khvalov/BattleDrome/(commit log)

2026-04-24 Create wheely.ino
    Initial code for Bluetooth controller and wheels drive
2026-04-24 Add central server dashboard and per-tank MQTT topics
    - Add server/index.js: subscribes to battledrome/tanks/+/events via MQTT,
    tracks online/offline state with 15s timeout, serves dashboard over HTTP
    and pushes real-time updates to browsers via WebSocket
    - Add server/public/index.html: dark-themed live dashboard showing each tank
    as a card with online/offline status, last-seen timestamp, and last event
    - Add server/package.json with mqtt and ws dependencies
    - Update eqipement/tanks/raspberry/server.js to publish on a per-tank topic
    (battledrome/tanks/{hostname}/events) so the central server can identify
    individual tanks via MQTT wildcard subscription
    - Add CLAUDE.md with project a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
2026-04-24 Add telemetry, heartbeat, command routing, and dashboard stats
    Arduino (wheely.ino):
    - Add game-state variables: health=100, ammo=100, ammoLevel=3,
    fireSpeed=5, immunable=false
    - Track per-motor abs speed; send avg as telemetry via Serial2 every 500ms
    - Parse incoming JSON commands on Serial2 to update variables at runtime
    - Use Serial2 (MegaPi predefined RPi UART) instead of Serial1
    - Requires ArduinoJson library
    Raspberry Pi (server.js):
    - Subscribe to battledrome/tanks/{hostname}/commands on connect
    - Forward received commands directly to Arduino via UART serial
    - Add heartbeat every 5s to prevent central server offline timeout
    Central server (server/index.js):
    - Merge telemetry paylo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
    [server.js, wheely.ino]
2026-04-25 Add IR firing, tank identity, fire events, and telemetry log
    wheely.ino:
    - Add TANK_ID ("WHLYA1") and TANK_TYPE ("wheely") settings constants
    - Add IR_TX_PIN placeholder (pin 3) with fireIR() stub — replace body
    with your IR library call (e.g. irsend.sendNEC)
    - Square button (PS2_SQUARE rising edge) triggers a shot when ammo > 0
    and fireSpeed ms have elapsed since the last shot
    - Each shot: decrements ammo by 1, calls fireIR(), sends fire event
    - fire event payload: tankId, tankType, senderId, ammoLevel, remaining ammo
    - telemetry payload now includes tankId and tankType
    raspberry/server.js:
    - Add getLocalIP() using os.networkInterfaces()
    - Enrich telemetry and fire events with ip and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
    [server.js, wheely.ino]
2026-04-29 Add RFID reader support and RFID-triggered action dispatch
    - Add MFRC522 RFID reader on RST_PIN=30, SS_PIN=22 via hardware SPI
    - readRfidUid() reads card UID as uppercase hex, halts card after read,
    applies 3 s per-UID debounce to prevent repeated triggers
    - sendRfidEvent() sends rfid JSON event over Serial2 on each scan
    - SPI.begin() + rfid.PCD_Init() added to setup()
    - Enrich rfid events with ip and hostname alongside telemetry and fire
    server/index.js:
    - Add RFID_ACTIONS map: UID → { param, value } command (commented examples
    for medkit, ammo crate, shield, nitro, power-up)
    - On rfid event: log UID + tank to console, look up action, publish
    comma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
    [server.js, wheely.ino]
2026-04-29 Fix handleCommand JSON buffer too small — commands silently dropped (#6)
    * Add RFID management UI with action/recipient/value rules and win overlay
    - Dashboard: RFID Actions section with colored table, add/edit/delete form
    - Server: REST API (GET/POST/DELETE /api/rfid), delta-based value dispatch
    - Win action broadcasts to browsers instead of sending tank command
    - Recipient routing: tank / others / teammate / all
    - Win overlay: full-screen trophy display with contextual message
    * Fix StaticJsonDocument too small in handleCommand — commands were silently dropped
    128 bytes was not enough for the incoming command JSON (~79 bytes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
    [wheely.ino]
2026-04-29 Add maxSpeed/minSpeed: default 160/20, RFID-overridable, shown in telemetry (#7)
    Firmware (wheely.ino):
    - Replace const MAX_SPEED=255 with int maxSpeed=160 (runtime-mutable)
    - Add int minSpeed=20 (floor applied to non-zero motor outputs)
    - applyMinSpd() helper enforces the floor after maxSpeed scaling
    - mecanumDrive() now clamps output to maxSpeed then raises to minSpeed
    - sendTelemetry() includes maxSpeed and minSpeed (doc bumped to 384)
    - handleCommand() handles maxSpeed [1,255] and minSpeed [0,255] params
    Server (index.js):
    - ACTION_PARAM: maxspeed→maxSpeed, minspeed→minSpeed
    - PARAM_RANGE: maxSpeed [1,255], minSpeed [0,255]
    - VALID_ACTIONS includes maxspeed and minspeed
    Dashboard (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
    [wheely.ino]
2026-04-29 Add WS2812 2x2 health LED on pin 60 (#8)
    - Include Adafruit_NeoPixel (install via Library Manager)
    - 4-pixel strip on pin 60 (= A6 on ATmega2560), brightness 80/255
    - updateHealthLed(): green (health>50) / yellow (health 5-50) / red (health<5)
    - Called at boot (setup) and immediately on every incoming health command
2026-04-29 Switch health LED from Adafruit_NeoPixel to MeRGBLed on pin A14 (#9)
    MeRGBLed is bundled with MeMegaPi — no extra library install needed.
    Pin changed from 60 to A14 (= pin 68 on ATmega2560).
    Setup: healthLed.setpin(A14); healthLed.setNumber(4);
    updateHealthLed() uses setColor(r,g,b) + show() — same colour zones:
    health > 50 → green | 5-50 → yellow | < 5 → red
    Also restores full file header lost during prior rebase stash.
2026-04-30 Hardware updates, dual LEDs, NEC IR, tank rename UI (#10)
    * Update SS_PIN, RFID cooldown, dual LEDs, NEC IR, system event handling
    - SS_PIN: 22 → 7
    - RFID_COOLDOWN_MS: 3000 → 5000
    - Add second MeRGBLed on A13 (led2); led1 stays on A14
    - Both LEDs yellow at boot (waiting for RPi), green when RPi sends
    system/connected via UART; health colours apply after that
    - handleCommand replaced by handleSerialLine: routes 'command' events
    as before, 'system/connected' sets rpiConnected and triggers LED switch
    - IR blaster moved from pin 3 to A12 (pin 66); fireIR() now sends a
    real 38 kHz NEC frame: addr = XOR-fold of TANK_ID, cmd = ammoLevel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
    [wheely.ino]
2026-04-30 Fix RFID silence and LEDs stuck yellow (#11)
    real 38 kHz NEC frame: addr = XOR-fold of TANK_ID, cmd = ammoLevel
    * Ad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
    [wheely.ino]
2026-04-30 Wheely: A6 SS_PIN, RFID debug logging, rename input focus fix (#12)
    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
    [wheely.ino]
2026-04-30 feat: ping-pong RPi connectivity check — fix LEDs stuck yellow on boot (#13)
    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
    [server.js, wheely.ino]
2026-04-30 debug: RPi serial write errors + MQTT subscription confirmation (#14)
    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
    [server.js]
2026-04-30 fix: RPi→Arduino serial pipeline — buffer overflow, minification, 64-byte guard (#15)
    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
    [server.js, wheely.ino]
2026-05-05 feat: implement 5 game modes in the web console (#16)
    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
2026-05-06 refactor(dashboard): redesign game panel UX for clarity
    Complete rework of the Game Control UI:
    Mode selector
    - Replaced dropdown with tabs — Free Play / CTF Teams / CTF Solo /
    Treasure Hunt / Race are always visible and one click to switch
    CTF Teams flow (the main pain point)
    - Step 1 label: "Create teams" with ＋ Add Team button that expands
    an inline form (name + color picker + home RFID UID)
    - Each team card shows a colored left bar, name, home UID, and a
    dedicated "Tanks in this team" section with named chips
    - Step 2 label: "Assign tanks" — each team card has a dropdown of
    unassigned tanks + "+ Add Tank" button; chips show current members
    with ✕ to remove; already-as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
2026-05-06 feat(trinity): rewrite firmware based on wheely architecture
    Hardware for this tank:
    - Motors: MeMegaPiDCMotor on PORT_1 (left) and PORT_4 (right) — differential
    drive, replaces the encoder-based Encoder_3/Encoder_4 of the old code
    - RFID: SS_PIN=6, RST_PIN=30 (SPI, same library as wheely)
    - IR receivers: A14 (pin 68) and A13 (pin 67), time-multiplexed with IRremote
    - IR transmitter: A12 (pin 66), wheely's software NEC implementation
    - No Raspberry Pi yet — Serial2 not started; status printed to USB serial only
    Key changes from old trinity.ino
    - Follows wheely.ino code structure (same game-state vars, same NEC TX code,
    same RFID debounce, same PWM timer setup, same fire-on-Square lo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
    [trinity.ino]
2026-05-06 feat(trinity): add Serial2/RPi support with full telemetry pipeline
    Enable UART communication with Raspberry Pi on Trinity tank:
    - Add ArduinoJson dependency for JSON encode/decode
    - Serial2.begin(115200) in setup() for Pi UART link
    - Ping-pong heartbeat every 5s; rpiConnected flag set on first pong
    - sendTelemetry() — health/ammo/speed/flags to Serial2 every 500ms
    - sendFireEvent() — immediate shot notification to Serial2
    - sendRfidEvent() — RFID scan forwarded to Pi (replaces TODO comment)
    - handleSerialLine() — parse incoming commands (health, ammo, ammoLevel,
    fireSpeed, immunable, maxSpeed, minSpeed); health and maxSpeed changes
    also call updateSpeedFromHealth() (Trinity-spec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
    [trinity.ino]
2026-05-06 fix(trinity): add missing SoftwareSerial.h include
    Required by MeMegaPi/MePS2 library chain — matches wheely.ino include order.
    [trinity.ino]
2026-05-06 fix(trinity): correct SS_PIN to A6 for RFID reader
    Pin 6 (digital) was wrong — RFID CS is wired to A6 (pin 60 on ATmega2560),
    same convention as wheely.
    [trinity.ino]
2026-05-06 feat(ir): add dual IR receive to wheely; update RX pins to A11/A10 on both tanks
    Wheely:
    - Add IRremote library include
    - IR RX on A11 (pin 65) + A10 (pin 64), time-multiplexed every 50 ms
    - handleIRReceive(): decode NEC, validate checksums, apply damage, blink red LED,
    update health LED, log attacker addr (0x<addr>) and damage
    - Wrap fireIR() with IrReceiver.stop()/start() to prevent TX self-capture
    - Add isDead / respawn() with START button (mirrors trinity)
    - IrReceiver.begin() in setup()
    Trinity:
    - Change IR RX pins from A14/A13 to A11/A10 (matching wheely hardware)
    - Log attacker addr (0x<addr>) in [HIT] message (matches wheely)
    - Fix stale RFID SS_PIN comment (A6, not pin 6)
    CLAUDE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
    [trinity.ino, wheely.ino]
2026-05-06 feat(combat): send hit events from firmware; server applies IR damage to health
    Firmware (wheely + trinity):
    - Add sendHitEvent(shooterAddr, damage): emits a 'hit' JSON event over Serial2
    immediately after an IR hit is decoded and local health is decremented
    - Fields: receiverId (this tank), shooterAddr (NEC addr byte = XOR-fold of
    attacker TANK_ID), damage (ammoLevel), health (post-hit value)
    - Call sendHitEvent() in handleIRReceive() after the Serial log line
    - Handle 'hit' event in mqttClient message handler
    - Resolve shooter identity by XOR-folding known tank IDs and matching addr byte
    - Compute newHealth = max(0, currentHealth - damage) using cached telemetry
    - U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
    [trinity.ino, wheely.ino]
2026-05-06 config: update default game-state values for trinity and wheely
    Trinity: fireSpeed 5 → 6
    Wheely: ammoLevel 3 → 1, fireSpeed 5 → 1
2026-05-06 docs(trinity): correct motor documentation — PWM brushed DC, no encoders
    - BOM: replace generic 'DC Motor Driver' with 'MegaPi PWM Motor Driver
    (MeMegaPiDCMotor)' and 'DC Motors' with 'Brushed DC Motors — PWM-controlled,
    no encoder feedback'
    - Motor mapping table: add PWM range column (-255…+255), note open-loop control
    - Deadzone description clarified
2026-05-07 fix(ir): use Timer5 for IRremote to avoid Timer2 conflict with MeMegaPi PWM
    IRremote defaults to Timer2 on ATmega2560. setup() then writes TCCR2A/TCCR2B
    to configure motor PWM, silently clobbering IRremote's timer ISR — the receive
    interrupt stops firing and no NEC frames are ever decoded.
    Fix: add #define IR_USE_AVR_TIMER5 before #include <IRremote.h> in both
    wheely and trinity. Timer5 (OC5A/5B/5C, pins 44-46) is not used by MeMegaPi
    motor drivers and is free for IRremote.
    [trinity.ino, wheely.ino]
2026-05-07 fix(ir): switch IRremote from Timer5 to Timer4 — Servo library conflict
    Timer5 (__vector_47) is owned by the Servo library bundled inside MeMegaPi,
    causing a 'multiple definition of __vector_47' linker error.
    Timer4 (pins 6/7/8) is not used by Servo, MeMegaPi motor PWM (Timer1/2),
    or Arduino core (Timer0), so it is safe for IRremote.
    [trinity.ino, wheely.ino]
2026-05-07 fix(ir): switch IRremote to Timer3 — Timer4 also conflicts with MeMegaPi
    Timer3 (pins 2/3/5) is the only 16-bit timer free from both the MeMegaPi
    motor PWM drivers (Timer1/2) and the Servo library (Timer4/5).
    [trinity.ino, wheely.ino]
2026-05-07 fix(ir): raise IR_SWITCH_MS 50→200 ms; add raw decode debug print
    IR_SWITCH_MS=50 was shorter than a NEC frame (~68 ms). IrReceiver.begin()
    called every 50 ms was resetting the decoder mid-frame, preventing any
    valid decode. Raised to 200 ms so the full frame always completes before
    the receiver pin is switched.
    Added [IR RAW] debug line in handleIRReceive() to print raw decoded value
    and protocol number — confirms whether IRremote Timer3 ISR is running and
    whether frames are reaching the NEC validation step.
    Remove the debug lines once hits are confirmed working.
    [trinity.ino, wheely.ino]
2026-05-07 chore(ir): remove [IR RAW] debug lines — hit pipeline confirmed working
    Full pipeline verified: NEC decode (proto=8) → [HIT] → sendHitEvent →
    server health command → [CMD] health applied on receiver.
2026-05-07 docs: update CLAUDE.md and wheely README for IR combat system
    CLAUDE.md:
    - Add 'hit' event type to message types table
    - Add SoftwareSerial to required libraries list
    - IR section: correct switch interval 50→200 ms, document Timer3 selection
    and full ATmega2560 timer allocation (why Timer1/2/4/5 are unavailable)
    - IR hit flow: document server-authoritative health command roundtrip
    - Game-state table: split into per-tank defaults (wheely vs trinity differ
    on ammoLevel and fireSpeed)
    Wheely README:
    - Add IRremote, SoftwareSerial to required libraries
    - Fix SS_PIN: 7 → A6 (= pin 60)
    - Add IR_RX_PIN_1/2 to tank settings table
    - Firing section: add IrReceiver.stop/start wrap, Serial2 fir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
2026-05-07 Add Free Play game mode with RFID-based home bases and respawn
    - Server: freeBases/freeReady/freeStates/freeScores/immunityDuration fields
    in game state; handleFreePlay() handles pre-game ready-check (idle) and
    RFID respawn (running); respawnTank() grants temporary immunity; hit handler
    tracks kills/deaths and updates W/L scores; startRound() validates all tanks
    are confirmed on their home bases before allowing start
    - Server API: PUT/DELETE /api/game/free-bases/:tankId; immunityDuration in
    PATCH /api/game; startRound returns {ok, reason} for client error messaging
    - UI: Free Play panel with home base assignment, ready indicators (On Base /
    Waiting), immunity duration setting; sc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
    [trinity.ino, wheely.ino]
2026-05-07 Redesign Free Play panel: show all tanks inline, no form toggle
    Replace the hidden Assign-Base form + dropdown with a flat list that
    shows every online tank immediately. Each row has an inline RFID UID
    input and a Set button — the user can see exactly what to do without
    opening any modal. Offline-but-configured tanks are also shown with
    an 'offline' tag. Enter key on the UID field triggers Set.
2026-05-07 Fix Free Play panel: always render tank rows, improve visibility
    - renderFpBases now called from refreshTankDropdowns unconditionally
    (even before game_update arrives) so tanks appear the moment they
    come online, without waiting for a full game state round-trip
    - Tab click re-renders the panel immediately with current _tanks
    - Replace subtle item-row with fp-tank-row card: darker bg, visible
    border, bold tank name, labelled input and Set Base button so users
    immediately see the controls
    - 'not in game' tag shown until base is assigned; ready/state badges
    appear after assignment
2026-05-07 Split telemetry log to dedicated page; auto-fill FP RFID from scan events
    - Add top-level Dashboard / Telemetry Log page tabs so telemetry WebSocket
    updates never trigger a re-render that blurs the Free Play RFID input fields
    - Unread badge on the Log tab counts non-telemetry events (fire, rfid, hit,
    system) while the user is on the Dashboard — clears on tab switch
    - appendLog: when an rfid event arrives, pre-populate the matching tank's
    fp-uid-{tankId} input (if empty) and flash its border green so the operator
    just clicks "Set Base" without typing
2026-05-07 Fix 3 FP panel bugs: log tab hidden, input blur, RFID auto-fill lost
    Bug 1 — Log tab always empty:
    showPage() was setting style.display='' which removes the inline style
    but the CSS rule #page-log{display:none} still wins. Fix: use 'block'.
    Bug 2 — Cannot type in RFID input / cursor lost every 500 ms:
    renderFpBases() did el.innerHTML=... on every telemetry tick, destroying
    focused inputs. Replaced with a DOM-diff approach: rows are created once
    (keyed by data-fp-id); subsequent calls update only badge spans and button
    states in-place. The <input> is never replaced, so focus is never stolen.
    Bug 3 — RFID auto-fill was wiped before operator could act:
    The server broadcast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
2026-05-08 Trinity: tank-stick controls, remove health-speed scaling, CTF Teams game logic
    - Trinity controls: LY=left track, RY=right track (replaces LY+RX differential mixing)
    - Remove health-based speed scaling from Trinity firmware; speed/health fully server-controlled
    - Add CTF Teams: friendly fire block, dead-can't-capture, respawn at own base, instant win on base capture, stop all tanks on time up
    - Validate teams have tanks and bases before starting CTF round
    - Implement teammate RFID recipient using actual team membership
    - Add AGENTS.md for OpenCode session onboarding
    - Update CLAUDE.md and Trinity README to reflect all changes
    [trinity.ino]
2026-05-08 Implement Treasure Hunt & Race modes, telemetry filters, team color swatches, UI improvements
    - Treasure Hunt: point collection via RFID tags, per-tank dedup, auto-register
    unknown tags as 1pt, optional shooting (50% speed reduction for 3s, no health
    damage), ranked scoreboard, game end overlay
    - Race: ordered checkpoint loop, lap tracking with correct/incorrect counts,
    auto-append unknown tags to checkpoint order, reorder buttons (up/down),
    optional shooting (same mechanics as Treasure Hunt), race progress panel
    - Telemetry Log: add tankId and event type filter dropdowns
    - Team color picker replaced with 10 preset color swatches
    - Dashboard layout: Game Setup panel moved above Tanks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
2026-05-11 Add FPV camera support: dashboard overlay + mediamtx systemd service docs
2026-05-27 Update boozy.ino
    LED matrix added
2026-05-29 Rocky: adopt wheely's LED visual-effects approach on 4x4 matrix
    Rocky has one WS2812 4x4 matrix (A9, 16 LEDs). The previous code
    incorrectly declared two non-existent 2x2 indicators (led1/led2 on
    A14/A13) and drove those via setAllLeds(), leaving the matrix with
    only a binary alive/dead treatment disconnected from the blink system.
    Changes (visual effects only — motor, game, IR, RFID logic untouched):
    - Remove led1 and led2 declarations (hardware does not exist)
    - Reroute setAllLeds() to drive the matrix via setColor(0,r,g,b)
    so all 16 LEDs respond as a single unit
    - setMatrixAlive() / setMatrixDead() are now thin wrappers of
    setAllLeds() — they go through the unified health/blink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
2026-05-29 Update rocky.ino
    Timer conflicts resolved by moving AUX motor to slot 3
    [rocky.ino]
2026-06-03 Firmware: fix LED hardware; add server-controlled led command (all 4 tanks)
    Hardware corrections
    Wheely: setNumber(4→9) on both 3×3 matrices (A14, A13)
    Boozy: remove non-existent led1/led2; reroute setAllLeds() → matrix (A9)
    Trinity: same as Boozy
    Rocky: already fixed; no hardware change
    LED behaviour (all tanks now identical)
    yellow → startup, waiting for RPi
    green → health > 50 (RPi connected)
    yellow → health 5–50
    red → health < 5 / dead
    red ×2 → IR hit / health command decreased
    green ×2 → health command increased (heal/respawn)
    New startBlinkN(r,g,b,n) (all 4 tanks)
    Allows variable blink count per effect.
    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
    [boozy.ino, rocky.ino, trinity.ino, wheely.ino]
2026-06-03 Docs: reflect all LED, command, and tank changes across all READMEs
    CLAUDE.md
    - Firmware table expanded to all 4 tanks (Wheely, Trinity, Rocky, Boozy)
    with LED hardware column
    - Wheely: corrected 2×2 → 3×3 matrices (9 LEDs each on A14/A13)
    - Trinity/Rocky/Boozy: single 4×4 matrix on A9 (led1/led2 removed)
    - Full LED colour table added (boot yellow, health gradient, hit/heal blinks)
    - Server-controlled LED effects table (led 1/2/3)
    - startBlinkN() documented
    - Tank-specific motor/LED sections added for Rocky and Boozy
    - Game-state defaults table expanded to all 4 tanks
    - 'led' added to valid command params list
    - Serial2 message size table: added 'command led' row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
2026-06-04 Add police-car LED effect on death; clear on respawn (all 4 tanks + server)
    Firmware (all tanks identical)
    New state variables: policeActive, policePhase, policeLast,
    POLICE_INTERVAL_MS (150 ms per phase).
    startPoliceLed() — cancels any pending one-shot blink, enters looping
    red/blue alternation at 150 ms per phase.
    stopPoliceLed() — clears the loop and immediately restores the
    health-based colour via updateHealthLed().
    updatePoliceLed() — called every loop() tick; non-blocking phase advance.
    updateBlink() — now skips if policeActive so police has full visual
    priority; one-shot blinks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
    [boozy.ino, rocky.ino, trinity.ino, wheely.ino]
2026-06-04 Update rocky.ino
    SPI fix
    [rocky.ino]
2026-06-06 Dashboard: wrench button per tank card with locked parameter overrides
    Each online tank card now has a ⚙ wrench button next to the rename pencil.
    Clicking it expands an inline settings panel with four inputs:
    Max Speed (1–255) · Min Speed (0–255) · Ammo Level (1–10) · Fire Speed (1–10)
    'Apply & Lock' sends all four params to the tank immediately and stores
    them in _tankOverrides. While a lock is active the wrench turns amber and
    a 🔒 locked badge appears in the panel.
    'Clear Lock' releases all overrides for that tank.
    Lock persistence until page refresh:
    reapplyOverrides() is called on every 'update' WebSocket message.
    For each locked param it compares the current tel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
2026-06-06 Fix settings panel not opening with multiple tanks
    Root cause: settings panel visibility was tracked via inline style.display
    (set by toggleTankSettings), but renderTanks would still full-re-render a
    card if the tank wasn't in _settingsOpen at the exact moment telemetry
    arrived — which happened reliably with 2+ tanks because telemetry events
    from different tanks stagger and fire renderTanks more frequently.
    Fix:
    - CSS now owns .tank-settings visibility: display:none by default,
    .tank-settings.open { display:block } makes it visible
    - _settingsOpen Set remains the authoritative state — no more relying on
    inline style as source of truth
    - renderTanks always does a full re-render (no _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
